eduardomdrs/rtc_therm_7seg/README.md

# rtc_therm_7seg
An arduino based project combining a RTC, a thermometer and a 4-digit 7 segment display.

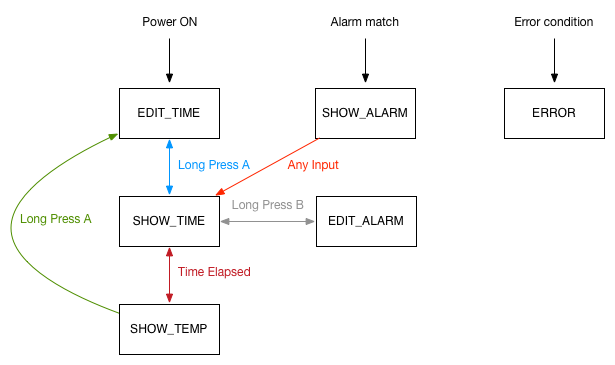
[picture p1: doc/state_transitions.png]
State transitions
