eduardomdrs/rtc_therm_7seg/doc/state_transitions.pdf

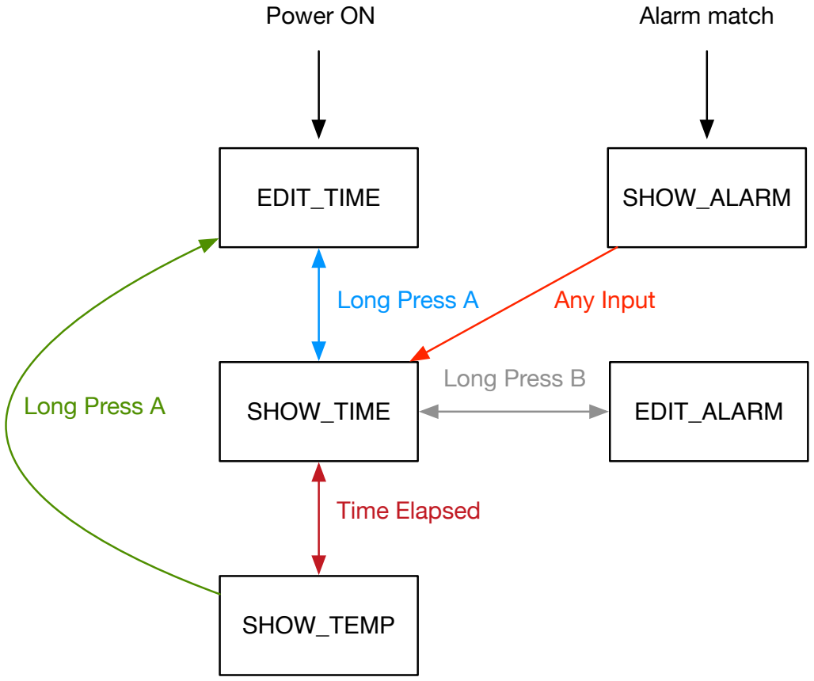
[picture p2: figure]
EDIT_TIME; SHOW_TIME; EDIT_ALARM; SHOW_TEMP; SHOW_ALARM; Power ON; Long Press A; Time Elapsed; Long Press B; Alarm match; Any Input

ERROR

Error condition
