eduardomdrs/rtc_therm_7seg/hardware/4_digit_7seg_driver.pdf

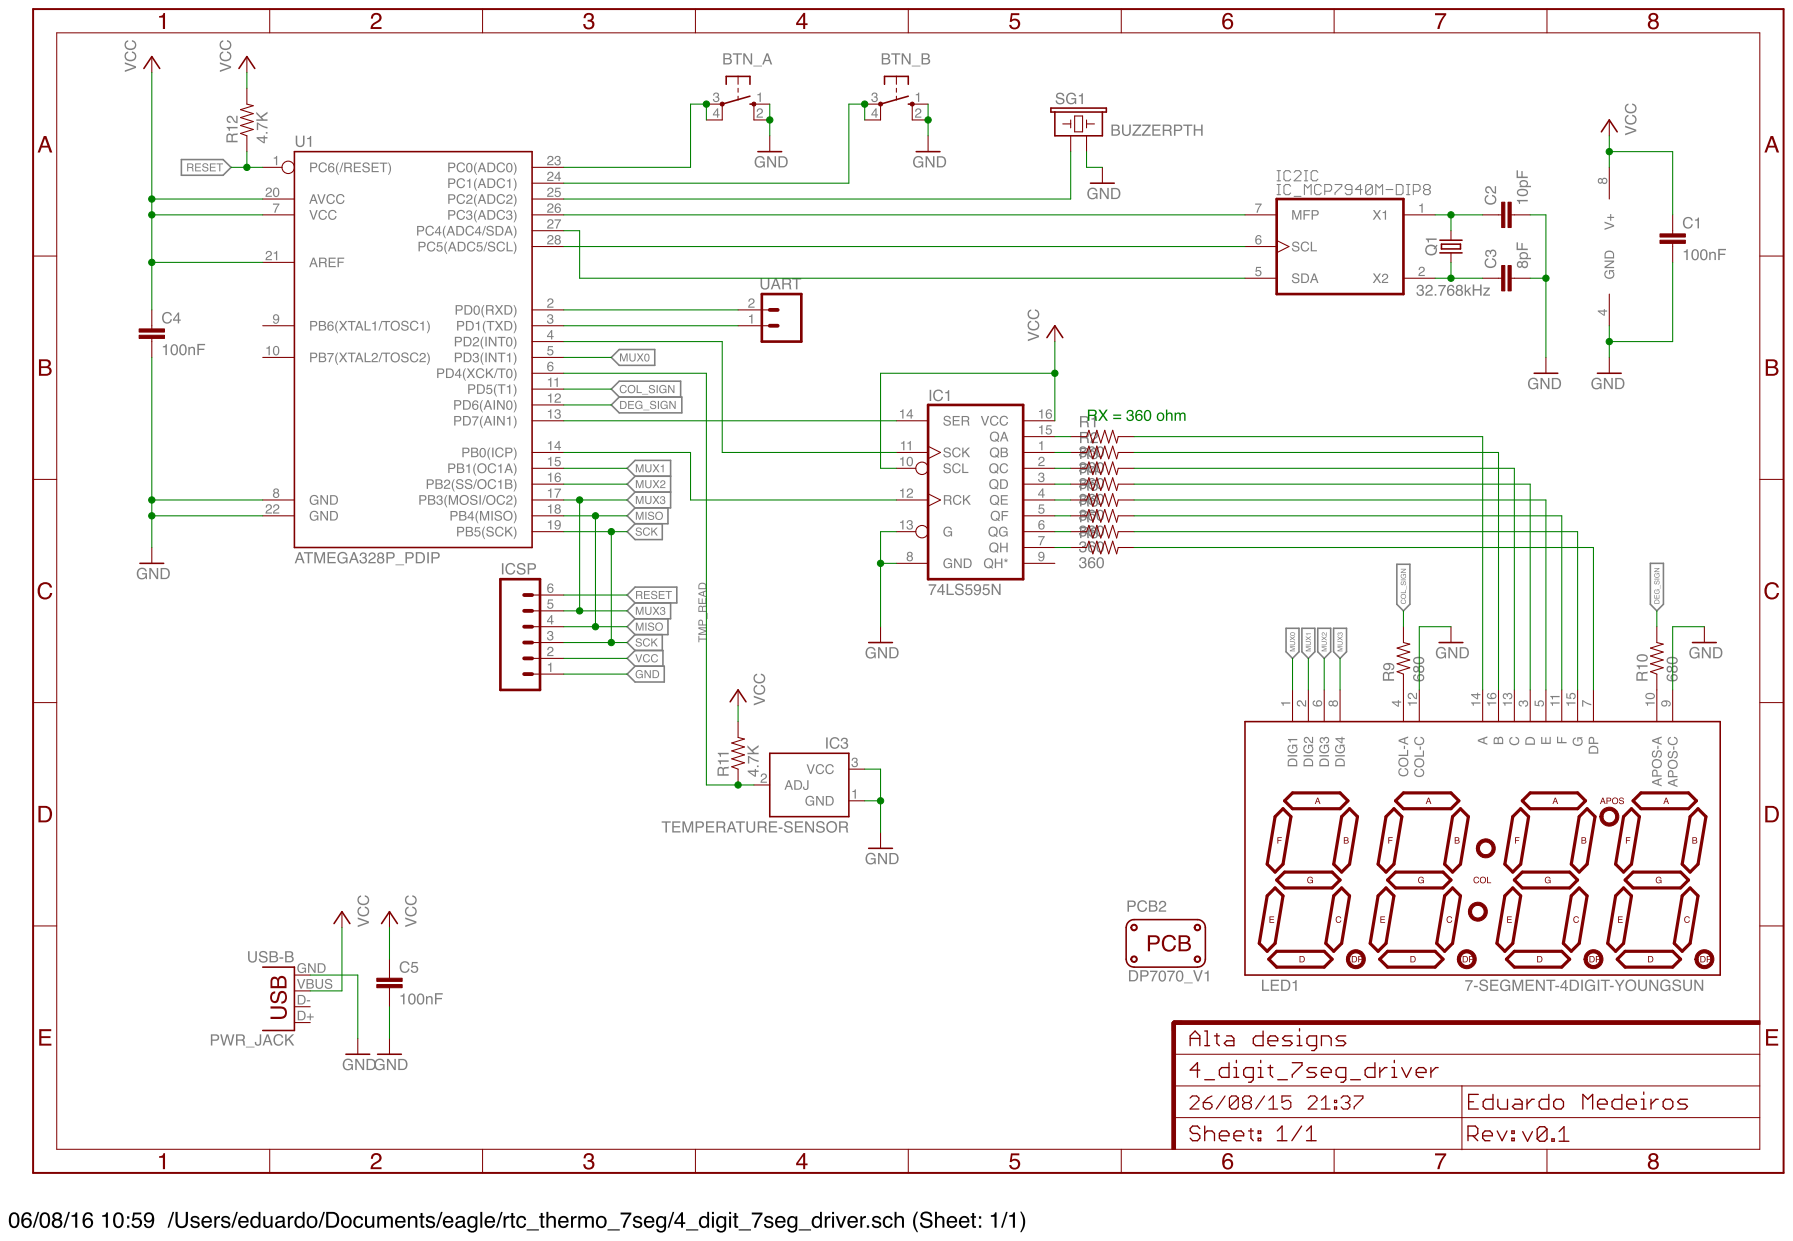
[picture p3: page 1]
