eduardomdrs/rtc_therm_7seg/hardware/4_digit_7seg_driver.brd

## EAGLE design hardware/4_digit_7seg_driver.brd (2016-08-06)

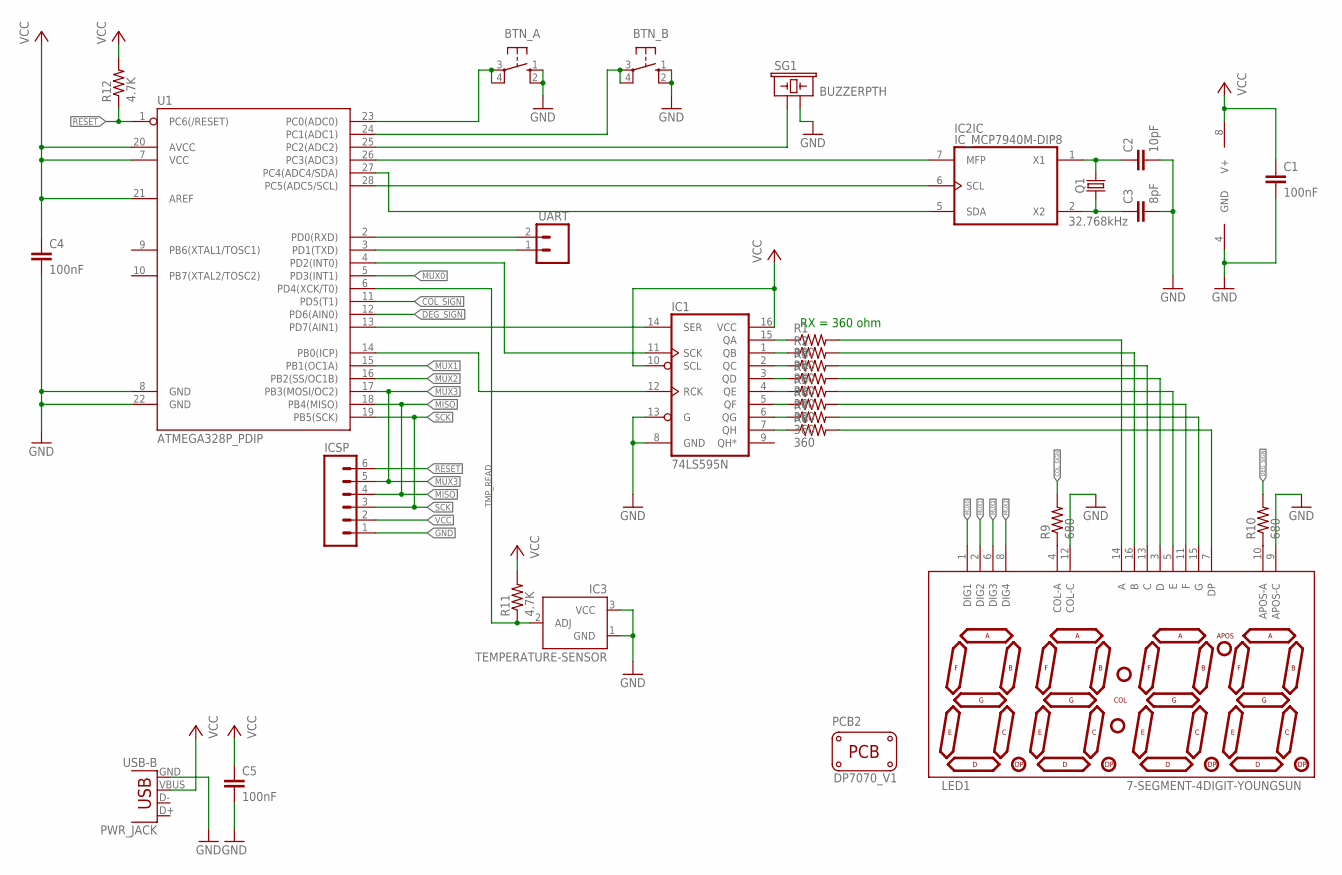
[picture p4: schematic 4_digit_7seg_driver.sch]

Parts:
BTN_A: 40-XX; B3F-40XX
BTN_B: 40-XX; B3F-40XX
C1, C4, C5: 100nF; CAP-PTH-5MM
C2: 10pF; CAP-PTH-SMALL
C3: 8pF; CAP-PTH-SMALL
IC1: 74LS595N; DIL16
IC2: IC_MCP7940M-DIP8; DIP8
IC3: TEMPERATURE-SENSOR; TO-92
ICSP: M06SILK_FEMALE_PTH; 1X06
LED1: 7-SEGMENT-4DIGIT-YOUNGSUN
PCB2: PCB_DP_SQUARE-7X7; DP7070_V1
PWR_JACK: USB-B; USB-B-PTH
Q1: 32.768kHz; TC26V
R1, R2, R3, R4, R5, R6, R7, R8: 360; AXIAL-0.1
R9, R10: 680; AXIAL-0.1
R11, R12: 4.7K; AXIAL-0.1
SG1: BUZZERPTH; BUZZER-12MM
U1: ATMEGA328P_PDIP; DIL28-3
UART: M02PTH; 1X02

Connections:
A: LED1.14 (A), R1.P$2 (2)
B: LED1.16 (B), R2.P$2 (2)
BUTTON_A: BTN_A.3, BTN_A.4 (P1), U1.23 (PC0(ADC0))
BUTTON_B: BTN_B.3, BTN_B.4 (P1), U1.24 (PC1(ADC1))
C: LED1.13 (C), R3.P$2 (2)
COL_SIGN: R9.P$2 (2), U1.11 (PD5(T1))
D: LED1.3 (D), R4.P$2 (2)
DEG_SIGN: R10.P$2 (2), U1.12 (PD6(AIN0))
DP: LED1.7 (DP), R8.P$2 (2)
E: LED1.5 (E), R5.P$2 (2)
F: LED1.11 (F), R6.P$2 (2)
G: LED1.15 (G), R7.P$2 (2)
GND: BTN_A.1 (S), BTN_A.2 (S1), BTN_B.1 (S), BTN_B.2 (S1), C1.2, C2.2, C3.2, C4.2, C5.2, IC1.8 (GND), IC1.13 (G), IC2.4 (GND), IC3.1 (GND), IC3.3 (VCC), ICSP.1, LED1.9 (APOS-C), LED1.12 (COL-C), PWR_JACK.GND, SG1.- (2), U1.8 (GND), U1.22 (GND)
MISO: ICSP.4, U1.18 (PB4(MISO))
MUX0: LED1.1 (DIG1), U1.5 (PD3(INT1))
MUX1: LED1.2 (DIG2), U1.15 (PB1(OC1A))
MUX2: LED1.6 (DIG3), U1.16 (PB2(SS/OC1B))
MUX3: ICSP.5, LED1.8 (DIG4), U1.17 (PB3(MOSI/OC2))
unnamed: IC1.15 (QA), R1.P$1 (1)
unnamed: IC1.1 (QB), R2.P$1 (1)
unnamed: IC1.2 (QC), R3.P$1 (1)
unnamed: IC1.3 (QD), R4.P$1 (1)
unnamed: IC1.4 (QE), R5.P$1 (1)
unnamed: IC1.5 (QF), R6.P$1 (1)
unnamed: IC1.6 (QG), R7.P$1 (1)
unnamed: IC1.7 (QH), R8.P$1 (1)
unnamed: LED1.4 (COL-A), R9.P$1 (1)
unnamed: IC2.6 (SCL), U1.28 (PC5(ADC5/SCL))
unnamed: IC2.5 (SDA), U1.27 (PC4(ADC4/SDA))
unnamed: IC2.7 (MFP), U1.26 (PC3(ADC3))
unnamed: SG1.+ (1), U1.25 (PC2(ADC2))
unnamed: C2.1, IC2.1 (X1), Q1.2
unnamed: LED1.10 (APOS-A), R10.P$1 (1)
unnamed: C3.1, IC2.2 (X2), Q1.1
RESET: ICSP.6, R12.P$1 (1), U1.1 (PC6(/RESET))
SCK: ICSP.3, U1.19 (PB5(SCK))
S_CLK: IC1.11 (SCK), U1.4 (PD2(INT0))
S_DATA: IC1.14 (SER), U1.13 (PD7(AIN1))
S_LATCH: IC1.12 (RCK), U1.14 (PB0(ICP))
TMP_READ: IC3.2 (ADJ), R11.P$1 (1), U1.6 (PD4(XCK/T0))
UART_RX: U1.2 (PD0(RXD)), UART.2
UART_TX: U1.3 (PD1(TXD)), UART.1
VCC: C1.1, C4.1, C5.1, IC1.10 (SCL), IC1.16 (VCC), IC2.8 (V+), ICSP.2, PWR_JACK.VBUS, R11.P$2 (2), R12.P$2 (2), U1.7 (VCC), U1.20 (AVCC), U1.21 (AREF)

Notes on the sheet:
RX = 360 ohm

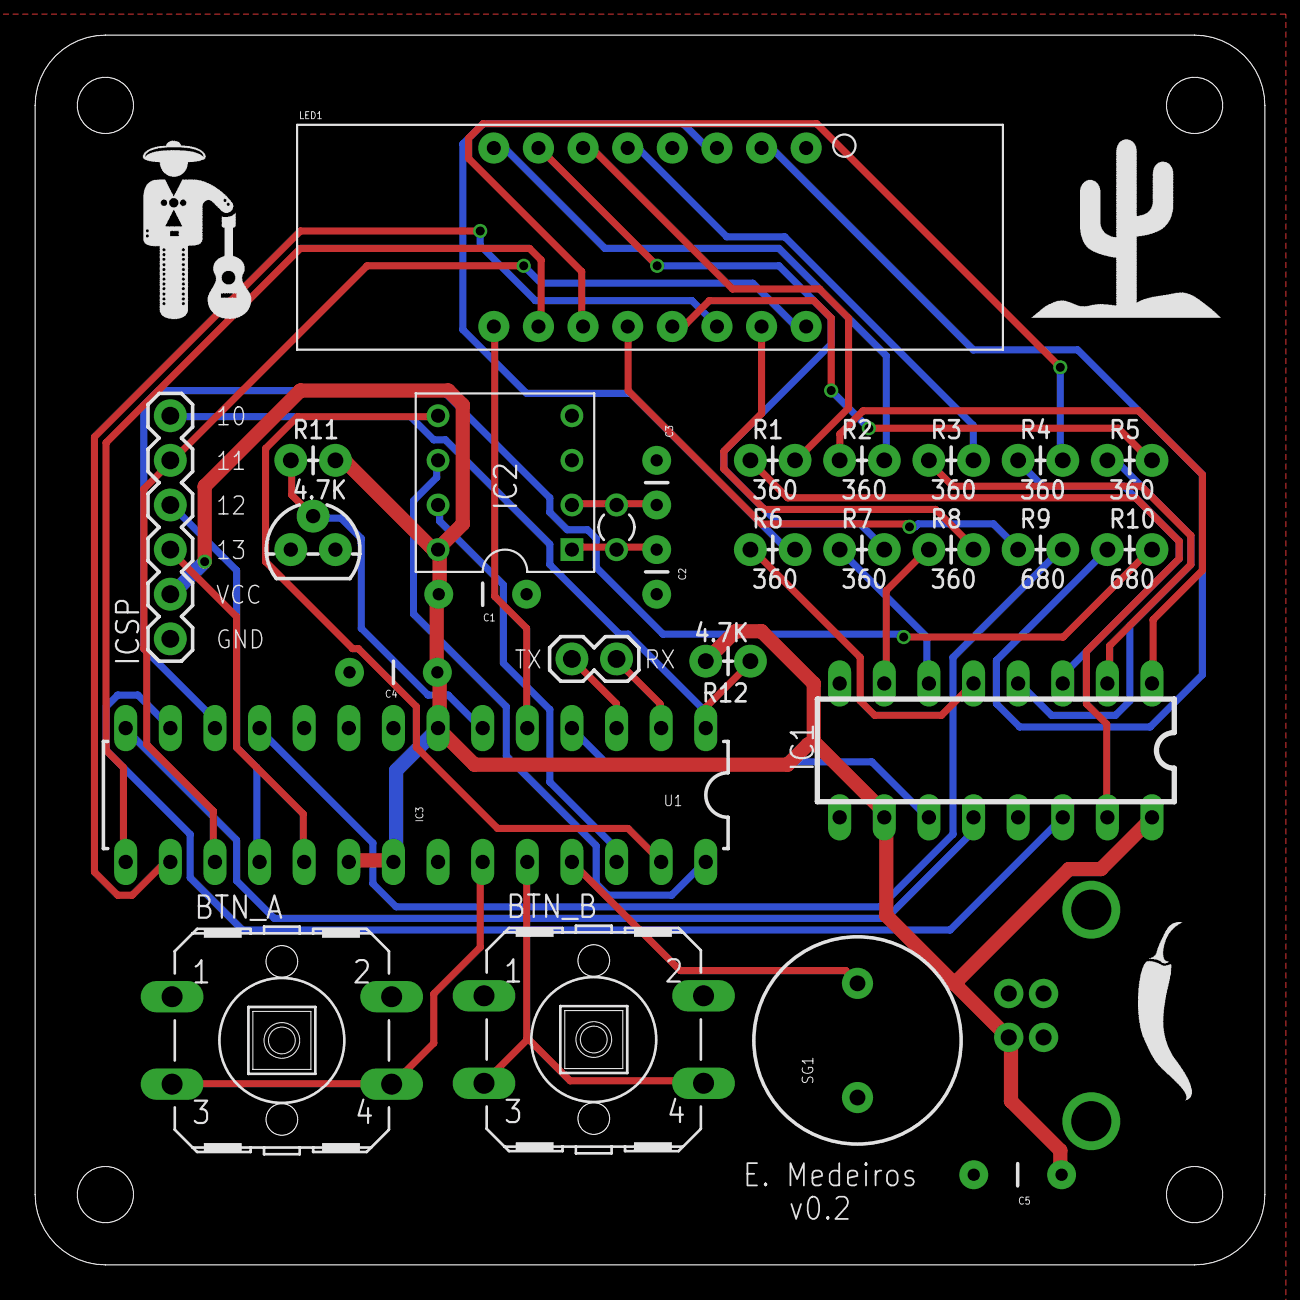
[picture p5: board 4_digit_7seg_driver.brd from above]

Board: 2 copper layers, 70.0 x 70.0 mm, 30 parts (1 on the bottom side), 43 nets.
