eduardomdrs/rtc_therm_7seg/src/SevenSegController.cpp

#include "SevenSegController.h"
#include "TimerOne.h"


SevenSegController *SevenSegController::active_object = 0;


SevenSegController::SevenSegController(int muxPin0, int muxPin1, int muxPin2, int muxPin3, int colonPin, int degreePin, int latchPin, int dataPin, int clkPin)
{
	active_object = this;

	_muxPins[0] = muxPin0;
	_muxPins[1] = muxPin1;
	_muxPins[2] = muxPin2;
	_muxPins[3] = muxPin3;

	for (int i = 0; i < _NO_DIGITS; ++i)
	{
		_digitStatus [i] = 0;
		_digitStatus [i] = _ENABLE_DIGIT;
		_blinkCounter[i] = 0;
		_showDecimal [i] = 0;
	}

	_colonPin   = colonPin;
	_degreePin  = degreePin;
	_latchPin   = latchPin;
	_dataPin    = dataPin;
	_clkPin     = clkPin;
	_brightness = 255;
	_selectedDigit = 0;

	pinMode(_muxPins[0], OUTPUT);
	pinMode(_muxPins[1], OUTPUT);
	pinMode(_muxPins[2], OUTPUT);
	pinMode(_muxPins[3], OUTPUT);
	pinMode(_colonPin , OUTPUT);
	pinMode(_degreePin, OUTPUT);
	pinMode(_latchPin , OUTPUT);
	pinMode(_dataPin  , OUTPUT);
	pinMode(_clkPin   , OUTPUT);

	Timer1.initialize(_MUX_PERIOD);
	Timer1.attachInterrupt(handle_interrupt);
}

void SevenSegController::writeDigit(byte digit, char value)
{
	_digitValues[digit] = value;
}

void SevenSegController::writeDigit(byte digit, byte value)
{
	_digitValues[digit] = (char) value;
}

void SevenSegController::writeMessage(const char* msg)
{
	for (int i = 0; i < _NO_DIGITS; i++)
		writeDigit(i, msg[i]);
}

void SevenSegController::disableDigit(byte digit)
{
	_digitStatus[digit] = _DISABLE_DIGIT;
}

void SevenSegController::enableDigit(byte digit)
{
	_digitStatus[digit] = _ENABLE_DIGIT;
}

void SevenSegController::enableDecimalPoint(byte digit)
{
	_showDecimal[digit] = 0xFE;
}

void SevenSegController::disableDecimalPoint(byte digit)
{
	_showDecimal[digit] = 0xFF;
}

void SevenSegController::enableBlink(byte digit)
{
	_digitStatus[digit] = _BLINK_DIGIT;
}

void SevenSegController::disableBlink(byte digit)
{
	enableDigit(digit);
}

void SevenSegController::setBrightness(byte brightness)
{
	_brightness = brightness;
}

void SevenSegController::enableDegreeSign()
{
	digitalWrite(_degreePin, HIGH);
}

void SevenSegController::disableDegreeSign()
{
	digitalWrite(_degreePin, LOW);
}

void SevenSegController::enableColon()
{
	digitalWrite(_colonPin, HIGH);
}

void SevenSegController::disableColon()
{
	digitalWrite(_colonPin, LOW);
}

void SevenSegController::enableBlinkDisplay()
{
	for (int i = 0; i < _NO_DIGITS; ++i)
		_digitStatus[i] = _BLINK_DIGIT;
}

void SevenSegController::disableBlinkDisplay()
{
	enableDisplay();
}

void SevenSegController::enableDisplay()
{
	for (int i = 0; i < _NO_DIGITS; ++i)
		_digitStatus[i] = _ENABLE_DIGIT;

	muxDisplay();
	Timer1.attachInterrupt(handle_interrupt);
}

void SevenSegController::disableDisplay()
{
	for (int i = 0; i < _NO_DIGITS; ++i)
		_digitStatus[i] = _DISABLE_DIGIT;
	
	muxDisplay();
	Timer1.detachInterrupt();
}

void SevenSegController::enableClockDisplay()
{
	disableDegreeSign();

	enableDigit(0);
	enableDigit(1);
	enableDigit(2);
	enableDigit(3);

	disableDecimalPoint(0);
	disableDecimalPoint(1);
	disableDecimalPoint(2);
	disableDecimalPoint(3);

	enableColon();
}

void SevenSegController::enableTempDisplay()
{
	disableColon();
	
	enableDigit(0);
	enableDigit(1);
	enableDigit(2);
	disableDigit(3);

	disableDecimalPoint(0);
	disableDecimalPoint(2);
	disableDecimalPoint(3);
	enableDecimalPoint(1);

	enableDegreeSign();
}

void SevenSegController::enableNumericDisplay()
{
	disableColon();
	enableDigit(0);
	enableDigit(1);
	enableDigit(2);
	enableDigit(3);
	disableDecimalPoint(0);
	disableDecimalPoint(1);
	disableDecimalPoint(2);
	disableDecimalPoint(3);
	disableDegreeSign();
}

// ------------------------------ //
//   Interrupt code
// ------------------------------ //


void SevenSegController::handle_interrupt()
{
	active_object->muxDisplay();
}

// void SevenSegController::muxDisplay(void)
// {
//     byte value = ( (translateDigit(_digitValues[_selectedDigit])) & _showDecimal[_selectedDigit] );
//     digitalWrite(_latchPin, LOW);
//     shiftOut(_dataPin, _clkPin, LSBFIRST, value);

//     digitalWrite(_muxPins[0], LOW);
//     digitalWrite(_muxPins[1], LOW);
//     digitalWrite(_muxPins[2], LOW);
//     digitalWrite(_muxPins[3], LOW);

//     if (_digitStatus[_selectedDigit] == 1)
//     {

//       analogWrite(_muxPins[_selectedDigit], _brightness);

//     } else if (_digitStatus[_selectedDigit] == 2)
//     {
//       if (_blinkCounter[_selectedDigit] < 2 * _BLINK_PERIOD)
//       {
//         if (_blinkCounter[_selectedDigit] < _BLINK_PERIOD)
//         {
//           analogWrite(_muxPins[_selectedDigit], _brightness);
//         }
//         _blinkCounter[_selectedDigit]++;

//       } else {
//         _blinkCounter[_selectedDigit] = 0;
//       }
//     }

//     digitalWrite(_latchPin, HIGH);

//     _selectedDigit++;
//     _selectedDigit %= _NO_DIGITS;
// }

void SevenSegController::muxDisplay(void)
{
	byte value = ( (translateDigit(_digitValues[_selectedDigit])) & _showDecimal[_selectedDigit] );
	digitalWrite(_latchPin, LOW);
	shiftOut(_dataPin, _clkPin, LSBFIRST, value);

	digitalWrite(_muxPins[0], LOW);
	digitalWrite(_muxPins[1], LOW);
	digitalWrite(_muxPins[2], LOW);
	digitalWrite(_muxPins[3], LOW);

	if (_digitStatus[_selectedDigit] == _ENABLE_DIGIT)
	{
		digitalWrite(_muxPins[_selectedDigit], HIGH);

	} else if (_digitStatus[_selectedDigit] == _BLINK_DIGIT)
	{
		
		if (_blinkCounter[_selectedDigit] < 2 * _BLINK_PERIOD)
		{
			
			if (_blinkCounter[_selectedDigit] < _BLINK_PERIOD)
			{
				digitalWrite(_muxPins[_selectedDigit], HIGH);
			}

			_blinkCounter[_selectedDigit]++;

		} else
		{
			_blinkCounter[_selectedDigit] = 0;
		}
	}

	digitalWrite(_latchPin, HIGH);

	_selectedDigit++;
	_selectedDigit %= _NO_DIGITS;
}


byte SevenSegController::translateDigit(char digit)
{
	byte returnVal = 0;

	switch (digit)
	{
		case 0:
		case 'O':
			returnVal =  B00000011;
			break;
		case 1:
			returnVal =  B10011111;
			break;
		case 2:
			returnVal =  B00100101;
			break;
		case 3:
			returnVal =  B00001101;
			break;
		case 4:
			returnVal =  B10011001;
			break;
		case 5:
			returnVal =  B01001001;
			break;
		case 6:
			returnVal =  B01000001;
			break;
		case 7:
			returnVal =  B00011111;
			break;
		case 8:
			returnVal =  B00000001;
			break;
		case 9:
			returnVal =  B00001001;
			break;
		case 'A':
		case 'R':
			returnVal =  B00010001;
			break;
		case 'a':
		case 'o':
			returnVal =  B11000101;
			break;
		case 'E':
			returnVal =  B01100001;
			break;
		case 'f':
		case 'F':
			returnVal =  B01110001;
			break;
		case 'n':
			returnVal =  B11010101;
			break;
		case 'N':
			returnVal =  B00010011;
			break;  
		case 'h':
			returnVal =  B11010001;
			break;
		case 'l':
			returnVal =  B11100011; 
			break;  
		case 'r':
			returnVal =  B11110101; 
			break;      
		case 'u':
			returnVal =  B11000111;
			break;
		default:
			returnVal =  B11111111;
			break;
	}

	return returnVal;
}
