eduardomdrs/rtc_therm_7seg/(commit log)

2015-07-25 adding initial files for 7seg display driver
2015-08-20 changes to support pwm pins instead of digital.
2015-09-19 changes to support playing alarm song, removing pwm muxing, slowing update frequency, removing interrupt when disabling display
2015-09-19 adding functionality for short display messages, changing digit representation from byte to char
    [SevenSegController.cpp, SevenSegController.h]
2015-12-08 many changes in the main script, fixed alarm functionality and reimplemented alarmAlert playing, enabling it to be stopped
    [SevenSegController.cpp, SevenSegController.h]
2016-08-06 adding pcb design files
    [4_digit_7seg_driver.brd, 4_digit_7seg_driver.sch]
